yu3ma/FSFR2100_LLC_SMPS/pcb/LLC-FSFR V12.png

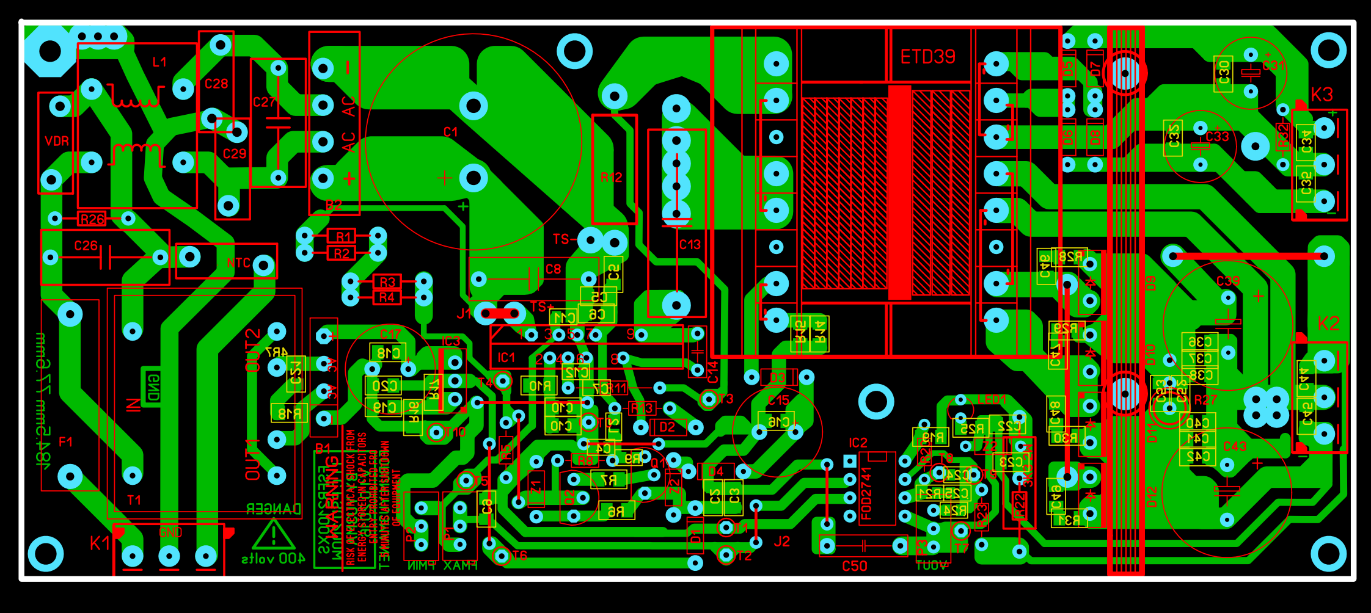
pcb/LLC-FSFR V12.png
