yu3ma/FSFR2100_LLC_SMPS/sch/FSFR2100_LLC_V121.png

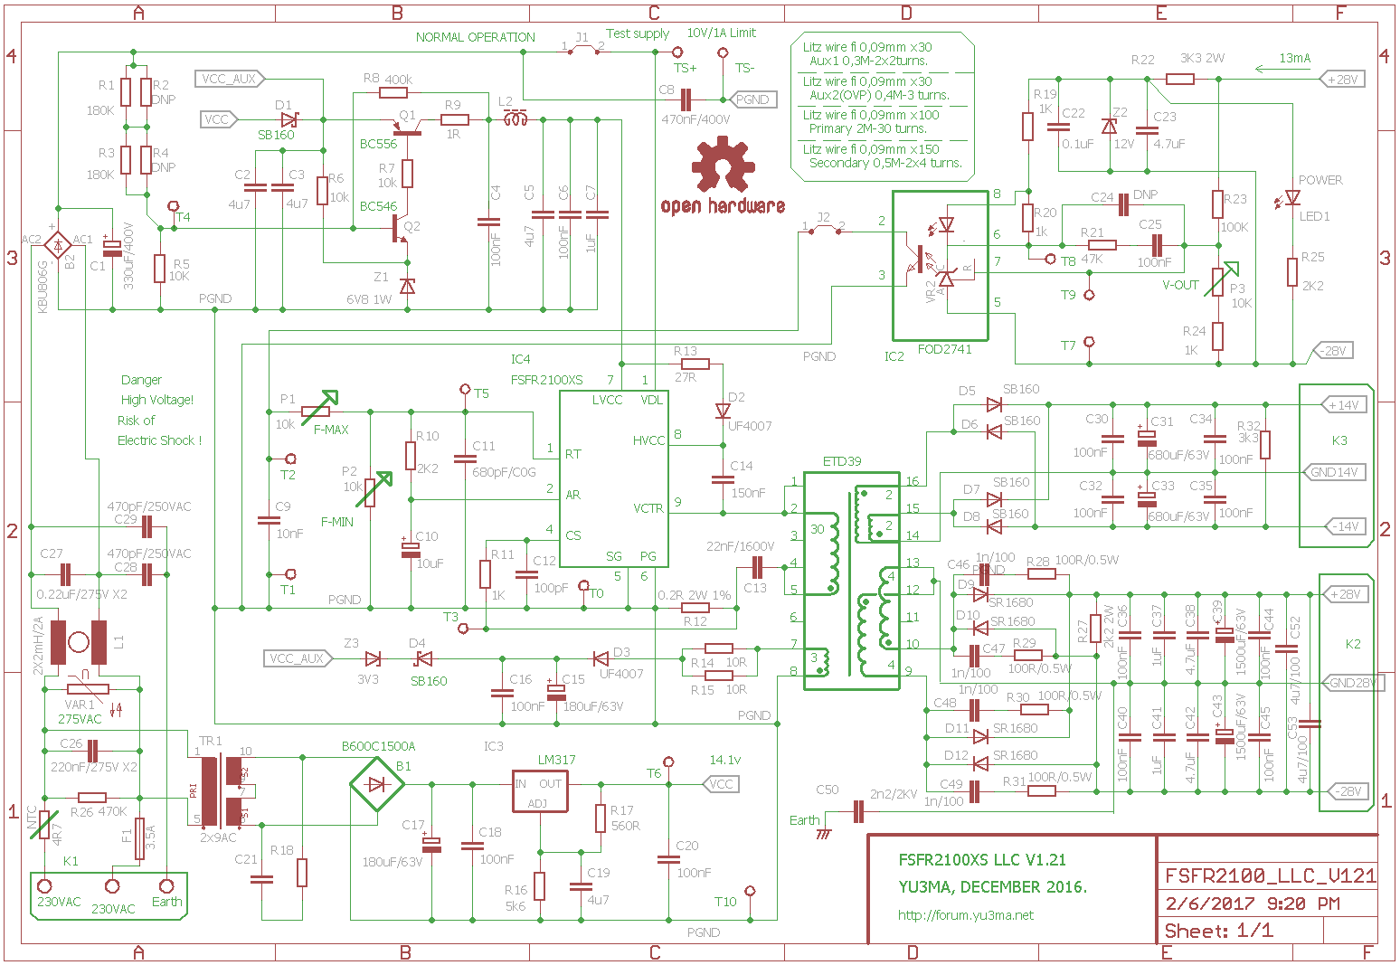
sch/FSFR2100_LLC_V121.png
