yu3ma/FSFR2100_LLC_SMPS/sch/FSFR2100_LLC_V121.pdf

# 4.7uF 2k2 2W

# C23 R²⁷

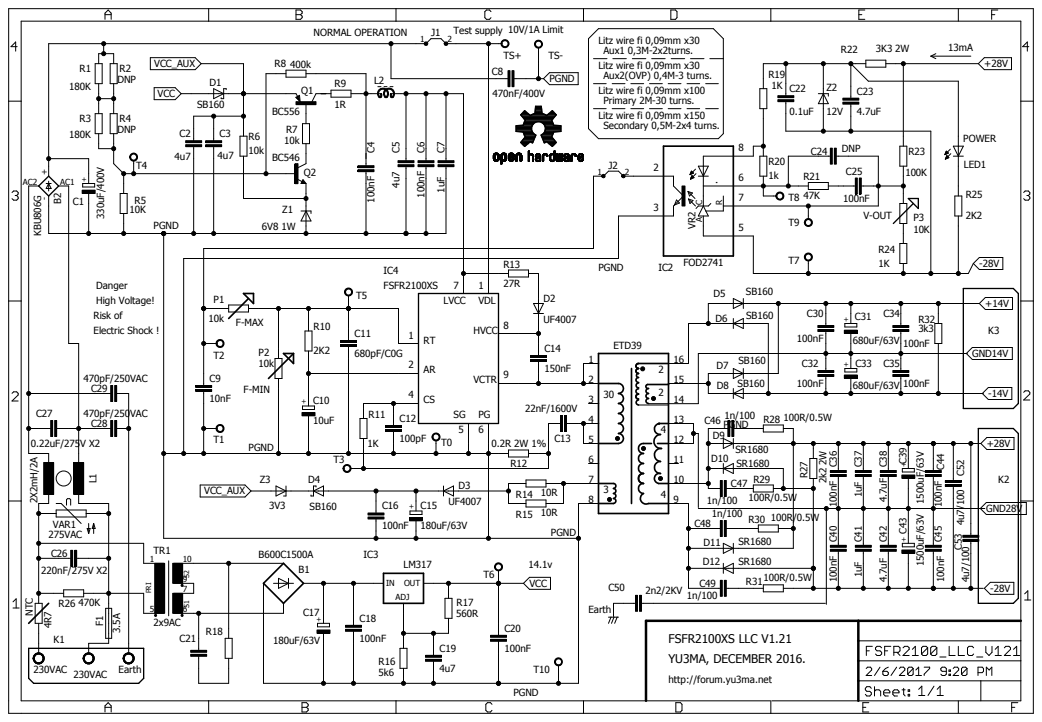
[picture p3: page 1]
