yu3ma/FSFR2100_LLC_SMPS/pcb/LLC-FSFR Boot V12.pdf

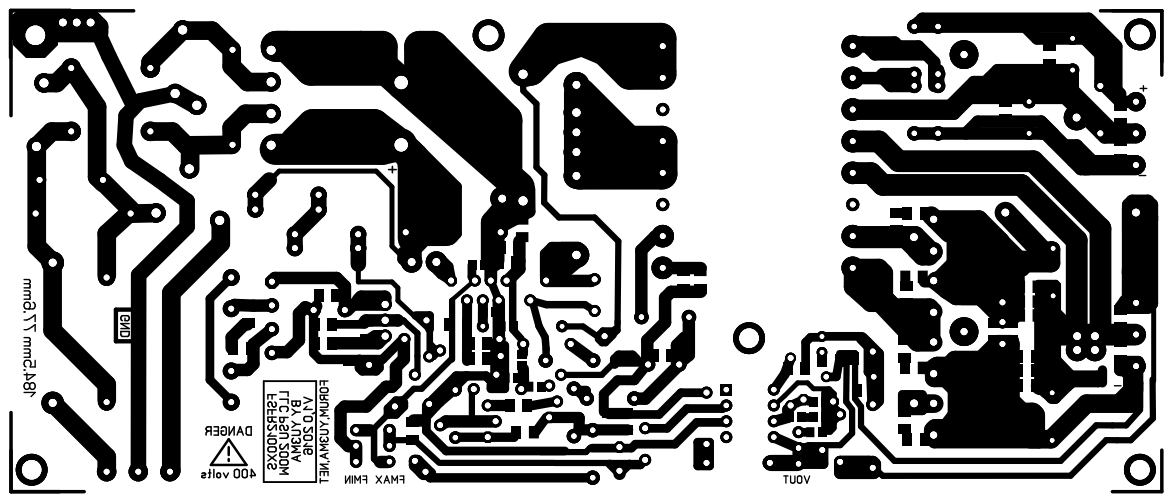
[picture p4: page 1]
