yu3ma/FSFR2100_LLC_SMPS/pcb/LLC-FSFR Smd-Mirror V12.pdf

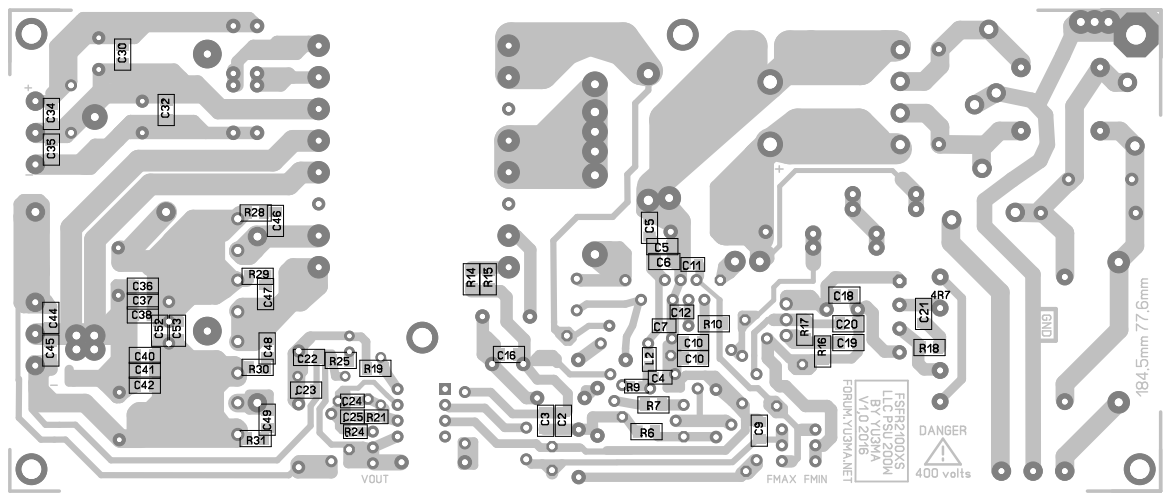
[picture p5: page 1]
