yu3ma/FSFR2100_LLC_SMPS/pcb/LLC-FSFR ALL V12.pdf

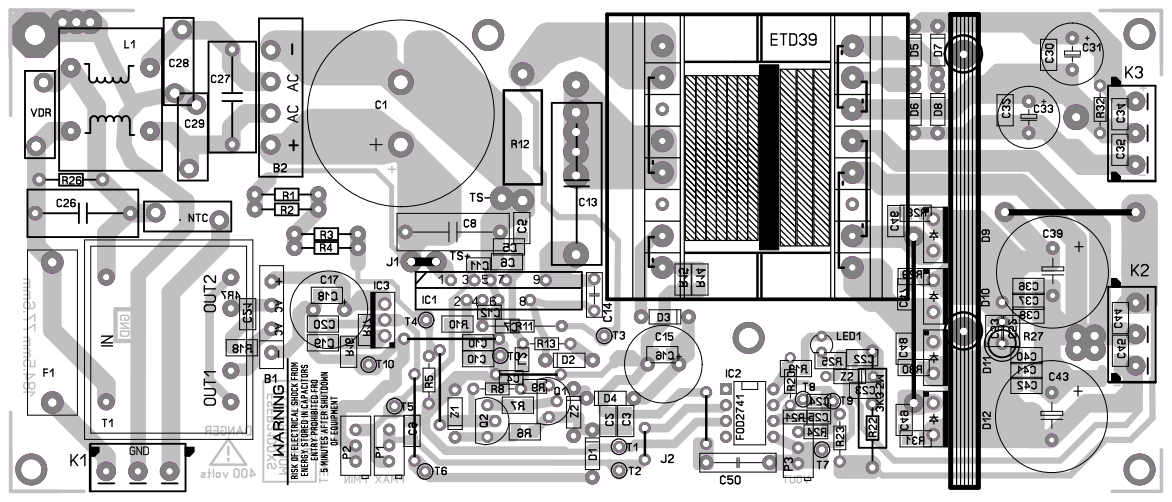
[picture p6: page 1]
