yu3ma/FSFR2100_LLC_SMPS/(list of files, drawings)

Other design files:
pcb/LLC-FSFR V12.lay6
