yu3ma/FSFR2100_LLC_SMPS/sch/FSFR2100_LLC_V121.sch

## EAGLE design sch/FSFR2100_LLC_V121.sch (2017-02-06)

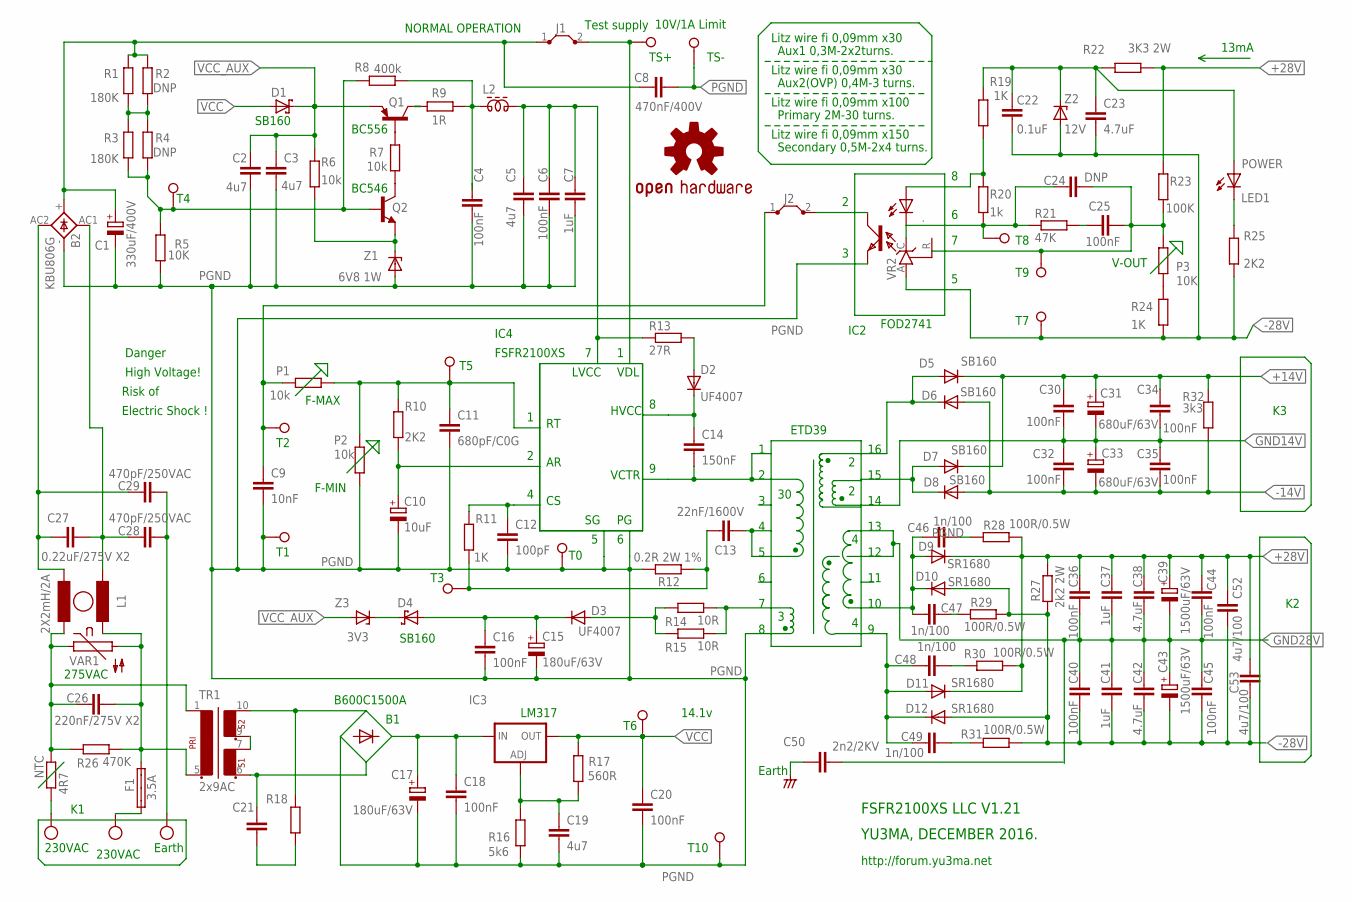
[picture p7: schematic FSFR2100_LLC_V121.sch]

Parts:
230V: MKDSN1,5/3-5,08; MPN SMKDSN1,5/3-5,08
.: LED3MM
B2: KBU806G; FBU4
C1: 330uF/400V; EB30D
C2, C3, C5, C19: 4u7; C1210
C4, C6, C16, C18, C20, C25: 100nF; C1210
C7: 1uF; C1210
C8: 470nF/400V; C1210
C9: 10nF; C1210
C10: 10uF; E2,5-6
C11: 680pF/C0G; C1210
C12: 100pF; C1210
C13: 22nF/1600V; C275-113X316
C14: 150nF; C102-043X133
C15: 180uF/63V; E3,5-8
C17: 180uF/63V; EB30D
C21: C-EUC1210; C1210
C22: 0.1uF; C1210
C23: 4.7uF; C1210
C24: DNP; C1210
C26: 220nF/275V X2; C150-084X183
C27: 0.22uF/275V X2; C150-084X183
C28, C29: 470pF/250VAC; C1210
C30, C32, C34, C35, C36, C40, C44, C45: 100nF; C1206
C31, C33: 680uF/63V; E3,5-8
C37, C41: 1uF; C1206
C38, C42: 4.7uF; C1206
C39, C43: 1500uF/63V; E7,5-18
C46, C47, C48, C49: 1n/100; C1210
C50: 2n2/2KV; C1210
C52, C53: 4u7/100; C1206
D1, D4: BAS40; SOT23
D2, D3, D16: UF4007; DO41-10
D5, D6, D7, D8: SB160; DO41-10
D9, D10, D11, D12: SR1680; DO41-10
F1: 3.5A; SHK20L
H: LPT80A
IC3: LM317TS; 317TS
J1, J2: J5MM; 05
L1: 2X2mH/2A; TL22
L2: ZD60820512; ZD6-2W5
LOGO1: OSHW-LOGOM; OSHW-LOGO-M
NTC: 4R7; 0207/10
P1, P2: 10k; R1206
P3: 10K; R1206
POWER: LED1; LED3MM
Q1: BC856ASMD; SOT23-BEC
Q2: BC846ASMD; SOT23
R1, R3: 180K; R1206
R2, R4: DNP; R1206
R5: 10K; R1206
R6, R7: 10k; R1206
R8: 400k; R1206
R9: 1R; R1206
R10, R25: 2K2; R1206
R11, R19, R24: 1K; R1206
R12: 0.2R 2W 1%; 0617/22
R13: 27R; R1206
R14, R15: 10R; 0617/22
R16: 5k6; R1206
R17: 560R; R1206
R18: R-EU_R1206; R1206
R20: 1k; R1206
R21: 47K; R1206
R22: 3K3 2W; R1206
R23: 100K; R1206
R26: 470K; 0207/10
R27: 2k2 2W; R1206
R28, R29, R30, R31: 100R/0.5W; R1206
R32: 3k3; R1206
T.P, T.P1, T.P2, T.P3, T.P4, T.P5, T.P6, T.P8, T.P9: W237-02P; W237-132
TR1: 2x9AC; EI30-2
VAR1: P595
VR2: TL431CLP; TO92-CLP
X1: W237-02P; W237-132
Z1: 6V8 1W; DO41Z10
Z2: 12V; DO41Z10
Z3: 3V3; DO41Z10

Connections:
+14V: C30.2, C31.+, C34.2, D5.C, D7.C, R32.1
+28V: C36.2, C37.2, C38.2, C39.+, C44.2, C52.2, C53.2, D9.C, D11.C, R27.1, R28.2, R30.2
+300V: B2.+, C1.+, C8.1, J1.1, R1.2, R2.2
-14V: C32.1, C33.-, C35.1, D6.A, D8.A, R32.2
-28V: C22.2, C23.2, R24.1, R25.2, T.P3.2, VR2.A, Z2.A
CON: C10.+, R10.2
CS: C12.1, R11.1
GND28V: C36.1, C37.1, C38.1, C39.-, C40.2, C41.2, C42.2, C43.+, C44.1, C45.2
HVCC: C14.1, D2.C
LVCC: C5.1, C6.1, C7.1, L2.2, R13.1
unnamed: POWER.K (C), R25.1
unnamed: Q2.2 (E), R6.2, Z1.C
unnamed: C19.1, IC3.1 (ADJ), R16.1, R17.1
unnamed: C20.1, IC3.2 (OUT), R17.2, T.P5.2
unnamed: P3.2, R24.2
unnamed: TR1.7 (4), TR1.9 (5)
unnamed: C8.2, X1.2
unnamed: 230V.2, F1.2A
unnamed: C4.1, L2.1, R8.1, R9.1
unnamed: C26.2, F1.1A, L1.3, R26.2, TR1.5 (2), VAR1.2
unnamed: B2.AC2 (AC1), C27.1, C29.1, L1.1 (2)
unnamed: R1.1, R2.1, R3.2, R4.2
unnamed: D2.A, R13.2
unnamed: Q1.B, R7.1
unnamed: Q2.3 (C), R7.2
unnamed: C9.1, J2.1, P1.1, T.P1.1
unnamed: ..A, R19.1, R20.1
unnamed: C25.1, R21.2
unnamed: C22.1, C23.1, POWER.A, R19.2, R22.1, Z2.C
unnamed: C40.1, C41.1, C42.1, C43.-, C45.1, C52.1, C53.1, D10.A, D12.A, R27.2, R29.2, R31.2
unnamed: C21.2, R18.1
unnamed: C24.2, C25.2, P3.1, R23.2, T.P9.1
unnamed: D3.A, R14.1, R15.1
unnamed: C15.+, C16.1, D3.C, D4.1 (A)
unnamed: ..K (C), C24.1, R20.2, R21.1, T.P9.2, VR2.C
unnamed: C13.2, R11.2, R12.2, T.P4.1
unnamed: H.C, J2.2
unnamed: Q1.C, R9.2
unnamed: C30.1, C32.2
unnamed: C31.-, C33.+
unnamed: C46.1, R28.1
unnamed: C48.2, C49.2, D11.A, D12.C
unnamed: C47.1, R29.1
unnamed: C48.1, R30.1
unnamed: B2.AC1 (AC2), C27.2, C28.1, L1.4
unnamed: C49.1, R31.1
unnamed: R22.2, R23.1
unnamed: C26.1, L1.2 (1), NTC.2, R26.1, TR1.1, VAR1.1
unnamed: 230V.3, C28.2, C29.2
unnamed: 230V.1, NTC.1
unnamed: Q2.1 (B), R3.1, R4.1, R5.2, R8.2, T.P3.1
unnamed: D5.A, D6.C
PGND: B2.-, C1.-, C2.2, C3.2, C4.2, C5.2, C6.2, C7.2, C9.2, C10.-, C11.2, C12.2, C13.1, C14.2, C15.-, C16.2, C17.+, C17.-, C18.1, C18.2, C19.2, C20.2, C21.1, C34.1, C35.2, C46.2, C47.2, D7.A, D8.C, D9.A, D10.C, H.E, IC3.3 (IN), P2.2, R5.1, R12.1, R14.2, R15.2, R16.2, R18.2, T.P.1, T.P6.1, T.P8.2, TR1.6 (3), TR1.10 (6), Z1.A
RT: C11.1, P1.2, P2.1, R10.1, T.P2.2
VCC_AUX: C2.1, C3.1, D1.3 (C), D4.3 (C), Q1.E, R6.1, Z3.C
VDL: J1.2, X1.1

Notes on the sheet:
FSFR2100XS LLC V1.21
YU3MA, DECEMBER 2016.
NORMAL OPERATION
Test supply
B600C1500A
F-MAX
F-MIN
FOD2741
LM317
http://forum.yu3ma.net
V-OUT
T10
IC2
ETD39
275VAC
BC546
BC556
TS+
TS-
230VAC
Earth
10V/1A Limit
13mA
Danger
High Voltage!
Risk of
14.1v
SB160
IC4
FSFR2100XS
HVCC
LVCC
VDL
VCTR
Litz wire fi 0,09mm x30
Aux1 0,3M-2x2turns.
Litz wire fi 0,09mm x100
Litz wire fi 0,09mm x150
Aux2(OVP) 0,4M-3 turns.
Primary 2M-30 turns.
Secondary 0,5M-2x4 turns.
Electric Shock !
