yu3ma/FSFR2100_LLC_SMPS/(commit log)

2016-12-09 FSFR PCB board size: 184.5mm 77.6mm
    [LLC-FSFR V10.lay6, LLC-FSFR-v1.0A.lay6]
2016-12-26 Add files via upload
    Transformer Secondary Slave 2x18v 14pin_Gnd
    [LLC-FSFR V10.lay6]
2016-12-26 Transformer Secondary Slave 2x18v 14pin_Gnd
    [FSFR2100_LLC_V10.sch]
2016-12-29 Output voltage slave +-14v.
    [FSFR2100_LLC_V11.sch]
2016-12-29 Delete FSFR2100_LLC_V10.sch
    nova verzija
    [FSFR2100_LLC_V10.sch]
2017-01-23 Added BOM list
2017-01-23 Designator fixes.
    [LLC-FSFR V12.lay6]
